StanleyAlbayeros/Smart-Arduino-Turret/UML/rtf/dir_6e195a7fbca2bebb78ee5c2c52944364.rtf

begin bodyD:/drkzt/Documents/Github Repos/Smart-Arduino-Turret/SAT Directory Reference
AAAAAAAABGAAAAAAAABGFiles
file Catapult.cpp
file Catapult.h
file Display.cpp
file Display.h
file Sensor.cpp
file Sensor.h
