StanleyAlbayeros/Smart-Arduino-Turret/UML/rtf/refman.rtf

Smart Arduino Turret

AUTHOR
Version
Wed May 24 2017

Table of Contents

Table of contents

Class Index
Class List
Here are the classes, structs, unions and interfaces with brief descriptions:
Catapult pagenum
Display pagenum
Sensor pagenum

File Index
File List
Here is a list of all files with brief descriptions:
D:/drkzt/Documents/Github Repos/Smart-Arduino-Turret/SAT/Catapult.cpp pagenum
D:/drkzt/Documents/Github Repos/Smart-Arduino-Turret/SAT/Catapult.h pagenum
D:/drkzt/Documents/Github Repos/Smart-Arduino-Turret/SAT/Display.cpp pagenum
D:/drkzt/Documents/Github Repos/Smart-Arduino-Turret/SAT/Display.h pagenum
D:/drkzt/Documents/Github Repos/Smart-Arduino-Turret/SAT/Sensor.cpp pagenum
D:/drkzt/Documents/Github Repos/Smart-Arduino-Turret/SAT/Sensor.h pagenum

Class Documentation
Catapult Class Reference
AAAAAAAAAJAAAAAAAAAJ
#include <Catapult.h>

Public Member Functions
Catapult (int firePin, int armPin, int ballsPin, int platformPin)
void sweep (Servo servo, int originAngle, int destinationAngle, int speed)
void rest ()
void prepareToShoot ()
void shoot ()
void openGate ()
void closeGate ()
void feedBall ()
void stepScan ()

Constructor & Destructor Documentation
Catapult::Catapult (int firePin, int armPin, int ballsPin, int platformPin)
AAAAAAAAAKAAAAAAAAAK
Member Function Documentation
void Catapult::closeGate ()
AAAAAAAAALAAAAAAAAALvoid Catapult::feedBall ()
AAAAAAAAAMAAAAAAAAAMvoid Catapult::openGate ()
AAAAAAAAANAAAAAAAAANvoid Catapult::prepareToShoot ()
AAAAAAAAAOAAAAAAAAAOvoid Catapult::rest ()
AAAAAAAAAPAAAAAAAAAPvoid Catapult::shoot ()
AAAAAAAAAQAAAAAAAAAQvoid Catapult::stepScan ()
AAAAAAAAARAAAAAAAAARvoid Catapult::sweep (Servo servo, int originAngle, int destinationAngle, int speed)
AAAAAAAAASAAAAAAAAAS
The documentation for this class was generated from the following files:
D:/drkzt/Documents/Github Repos/Smart-Arduino-Turret/SAT/Catapult.h
D:/drkzt/Documents/Github Repos/Smart-Arduino-Turret/SAT/Catapult.cpp

Display Class Reference
AAAAAAAAATAAAAAAAAAT
#include <Display.h>

Public Member Functions
Display ()
void displayRange (uint8_t range)
void preparing ()
void shooting ()
void scanning ()
void detected ()

Constructor & Destructor Documentation
Display::Display ()
AAAAAAAAAUAAAAAAAAAU
Member Function Documentation
void Display::detected ()
AAAAAAAAAVAAAAAAAAAVvoid Display::displayRange (uint8_t range)
AAAAAAAAAWAAAAAAAAAWvoid Display::preparing ()
AAAAAAAAAXAAAAAAAAAXvoid Display::scanning ()
AAAAAAAAAYAAAAAAAAAYvoid Display::shooting ()
AAAAAAAAAZAAAAAAAAAZ
The documentation for this class was generated from the following files:
D:/drkzt/Documents/Github Repos/Smart-Arduino-Turret/SAT/Display.h
D:/drkzt/Documents/Github Repos/Smart-Arduino-Turret/SAT/Display.cpp

Sensor Class Reference
AAAAAAAABAAAAAAAAABA
#include <Sensor.h>

Public Member Functions
Sensor ()
Sensor (Ultrasonic mySensor)
Sensor (int triggerPin, int echoPin)
bool detectTarget (int range)
uint8_t getDistanceMap ()

Constructor & Destructor Documentation
Sensor::Sensor ()
AAAAAAAABBAAAAAAAABBSensor::Sensor (Ultrasonic mySensor)
AAAAAAAABCAAAAAAAABCSensor::Sensor (int triggerPin, int echoPin)
AAAAAAAABDAAAAAAAABD
Member Function Documentation
bool Sensor::detectTarget (int range)
AAAAAAAABEAAAAAAAABEuint8_t Sensor::getDistanceMap ()
AAAAAAAABFAAAAAAAABF
The documentation for this class was generated from the following files:
D:/drkzt/Documents/Github Repos/Smart-Arduino-Turret/SAT/Sensor.h
D:/drkzt/Documents/Github Repos/Smart-Arduino-Turret/SAT/Sensor.cpp

File Documentation
D:/drkzt/Documents/Github Repos/Smart-Arduino-Turret/SAT/Catapult.cpp File Reference
AAAAAAAAAAAAAAAAAAAA#include "Catapult.h"
Include dependency graph for Catapult.cpp:
IMAGE

D:/drkzt/Documents/Github Repos/Smart-Arduino-Turret/SAT/Catapult.h File Reference
AAAAAAAAABAAAAAAAAAB#include "Arduino.h"
#include <Servo.h>

Include dependency graph for Catapult.h:
IMAGE

This graph shows which files directly or indirectly include this file:
IMAGE

Classes
class Catapult

D:/drkzt/Documents/Github Repos/Smart-Arduino-Turret/SAT/Display.cpp File Reference
AAAAAAAAACAAAAAAAAAC#include "Display.h"
Include dependency graph for Display.cpp:
IMAGE

D:/drkzt/Documents/Github Repos/Smart-Arduino-Turret/SAT/Display.h File Reference
AAAAAAAAADAAAAAAAAAD#include "Arduino.h"
#include <Adafruit_GFX.h>

#include <Adafruit_NeoPixel.h>

#include <Adafruit_NeoMatrix.h>

#include <LiquidCrystal.h>

Include dependency graph for Display.h:
IMAGE

This graph shows which files directly or indirectly include this file:
IMAGE

Classes
class Display
Macros
#define neoPixelMatrix

Macro Definition Documentation
#define neoPixelMatrix

AAAAAAAAAEAAAAAAAAAE

D:/drkzt/Documents/Github Repos/Smart-Arduino-Turret/SAT/Sensor.cpp File Reference
AAAAAAAAAFAAAAAAAAAF#include "Sensor.h"
Include dependency graph for Sensor.cpp:
IMAGE

D:/drkzt/Documents/Github Repos/Smart-Arduino-Turret/SAT/Sensor.h File Reference
AAAAAAAAAGAAAAAAAAAG#include "Arduino.h"
#include <Ultrasonic.h>

Include dependency graph for Sensor.h:
IMAGE

This graph shows which files directly or indirectly include this file:
IMAGE

Classes
class Sensor
Macros
#define DEFAULT_TRIGGER_PIN 3

#define DEFAULT_ECHO_PIN 2

Macro Definition Documentation
#define DEFAULT_ECHO_PIN 2

AAAAAAAAAHAAAAAAAAAH#define DEFAULT_TRIGGER_PIN 3
AAAAAAAAAIAAAAAAAAAI
Index
INDEX
