StanleyAlbayeros/Smart-Arduino-Turret/(commit log)

2017-05-16 Sprint 3
    Some modifications to the code from the project this is based upon ( https://www.instructables.com/id/Arduino-Robot-Catapult/ ).
2017-05-23 Starting auxiliary classes
    Cleaned up some of the code and started to work on the classes that will be used by the boards.
2017-05-24 i2c implemented
2017-05-31 I2C pwm implemented!
